giovannibarbera/commutator/CAD_files/sldprt/tube_clamp.SLDPRT

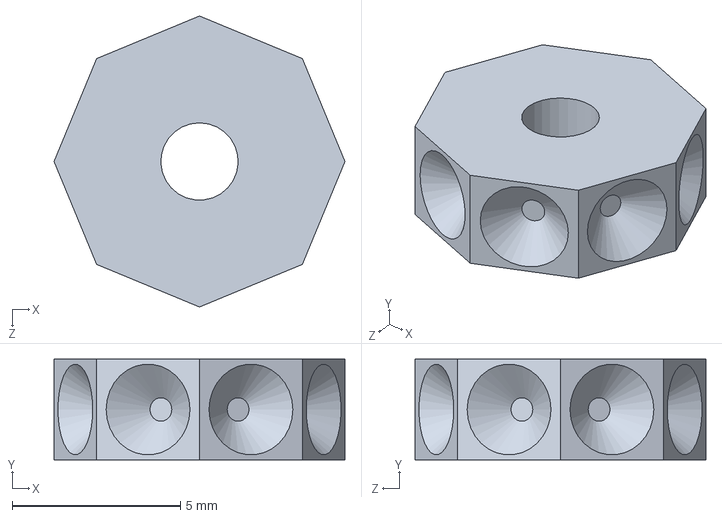
[picture p1: CAD file, 2025-06-23]
CAD_files/sldprt/tube_clamp.SLDPRT
8.66 x 3.00 x 8.66 mm
