giovannibarbera/commutator/CAD_files/sldprt/frame.SLDPRT

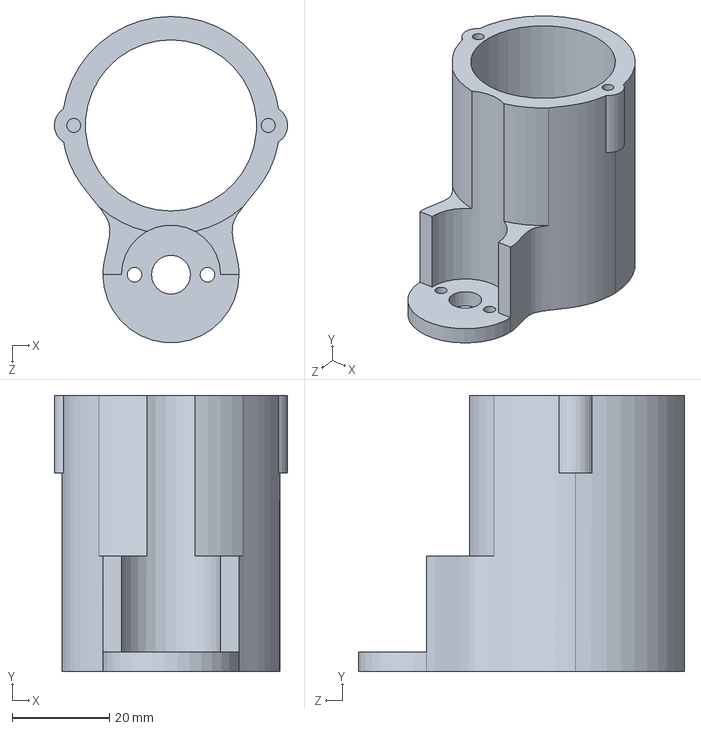
[picture p2: CAD file, 2025-06-23]
CAD_files/sldprt/frame.SLDPRT
48.0 x 56.8 x 67.0 mm
