giovannibarbera/commutator/CAD_files/sldprt/rotor_gear.SLDPRT

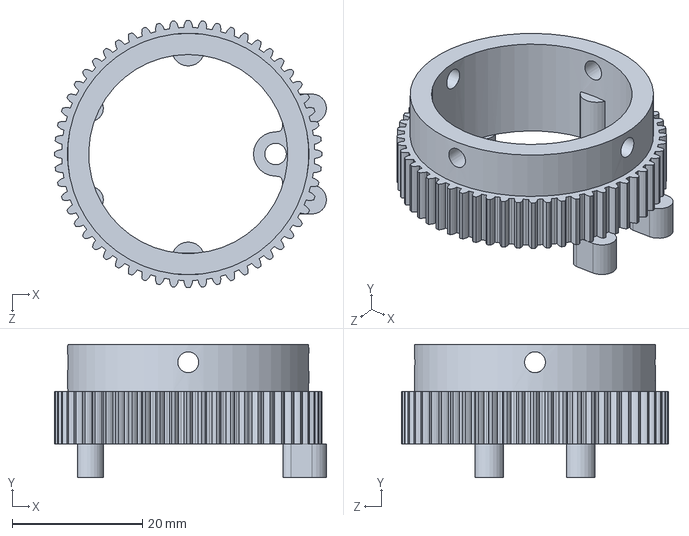
[picture p3: CAD file, 2025-06-23]
CAD_files/sldprt/rotor_gear.SLDPRT
41.7 x 20.5 x 41.0 mm
