giovannibarbera/commutator/CAD_files/sldprt/cable_ring.SLDPRT

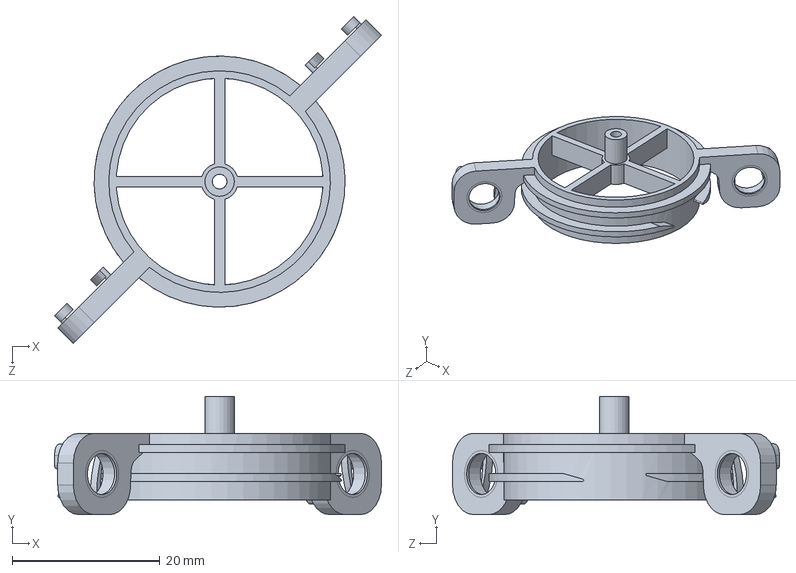
[picture p4: CAD file, 2025-06-23]
CAD_files/sldprt/cable_ring.SLDPRT
44.3 x 16.0 x 44.3 mm
