giovannibarbera/commutator/CAD_files/sldprt/top_swivel.SLDPRT

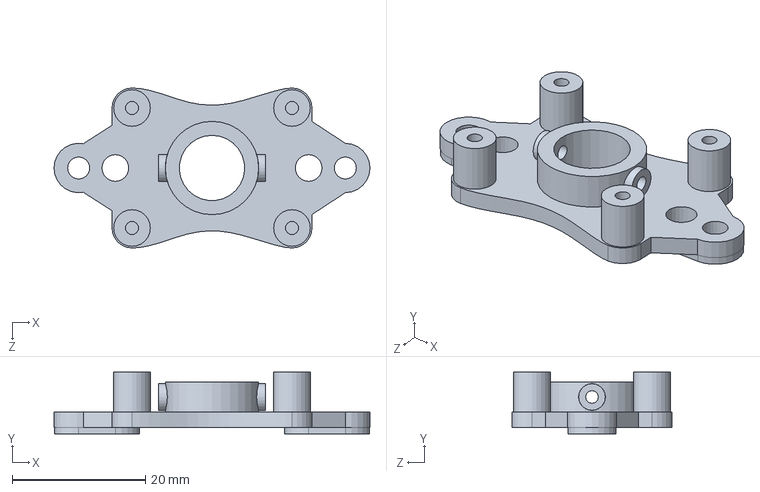
[picture p5: CAD file, 2025-06-23]
CAD_files/sldprt/top_swivel.SLDPRT
47.4 x 9.30 x 24.0 mm
