giovannibarbera/commutator/CAD_files/sldprt/bottom_frame.SLDPRT

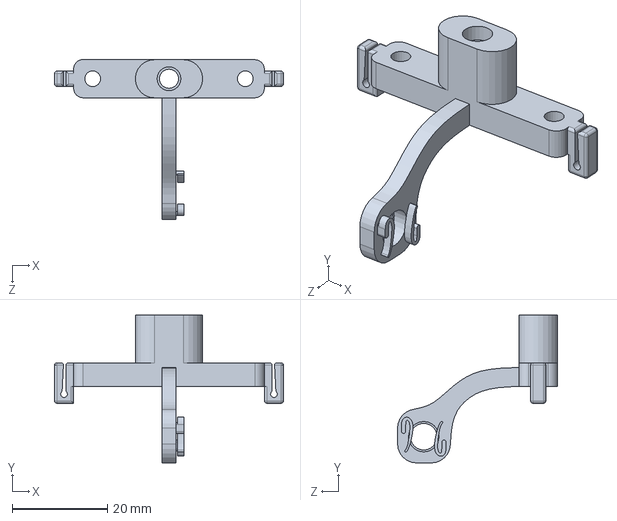
[picture p6: CAD file, 2025-06-23]
CAD_files/sldprt/bottom_frame.SLDPRT
48.0 x 31.0 x 33.5 mm
