giovannibarbera/commutator/CAD_files/sldprt/magnet_holder.SLDPRT

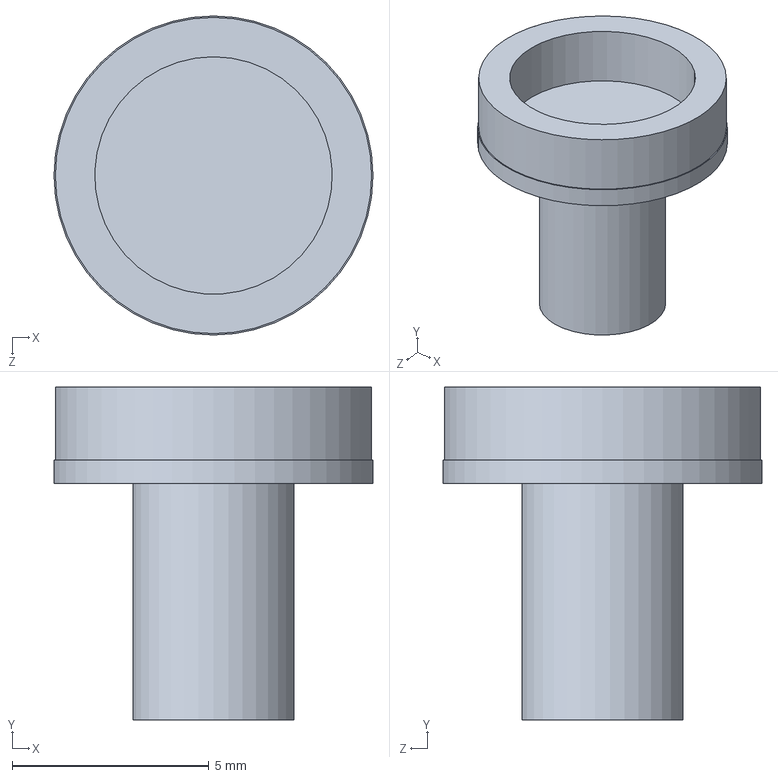
[picture p7: CAD file, 2025-06-23]
CAD_files/sldprt/magnet_holder.SLDPRT
8.10 x 8.45 x 8.10 mm
