giovannibarbera/commutator/CAD_files/sldprt/motor_gear.SLDPRT

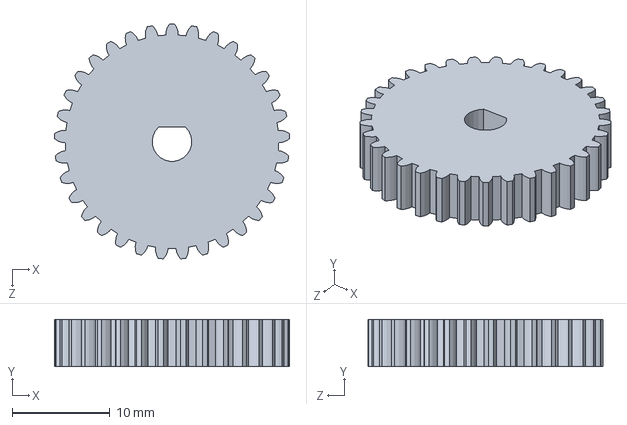
[picture p8: CAD file, 2025-06-23]
CAD_files/sldprt/motor_gear.SLDPRT
24.0 x 4.80 x 24.0 mm
