giovannibarbera/commutator/CAD_files/sldprt/cable_standoff.SLDPRT

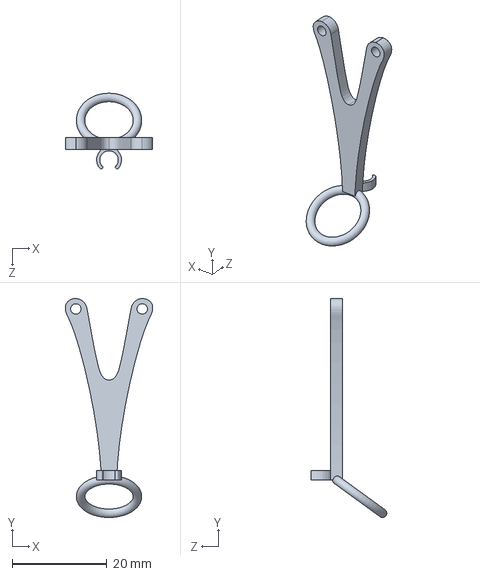
[picture p9: CAD file, 2025-06-23]
CAD_files/sldprt/cable_standoff.SLDPRT
18.4 x 46.2 x 15.9 mm
