giovannibarbera/commutator/(list of files, cad)

Other CAD files:
CAD_files/stl/bottom_frame.STL
CAD_files/stl/cable_ring.STL
CAD_files/stl/cable_standoff.STL
CAD_files/stl/frame.STL
CAD_files/stl/magnet_holder.STL
CAD_files/stl/motor_gear.STL
CAD_files/stl/rotor_gear.STL
CAD_files/stl/top_swivel.STL
CAD_files/stl/tube_clamp.STL
